rilmar/chimera-toolchanger/3MF/README.md

To print use the standard voron settings. Not all parts are oriented correctly. All part should print without supports.
