rilmar/chimera-toolchanger/3MF/Chimera SB Mounting.3mf

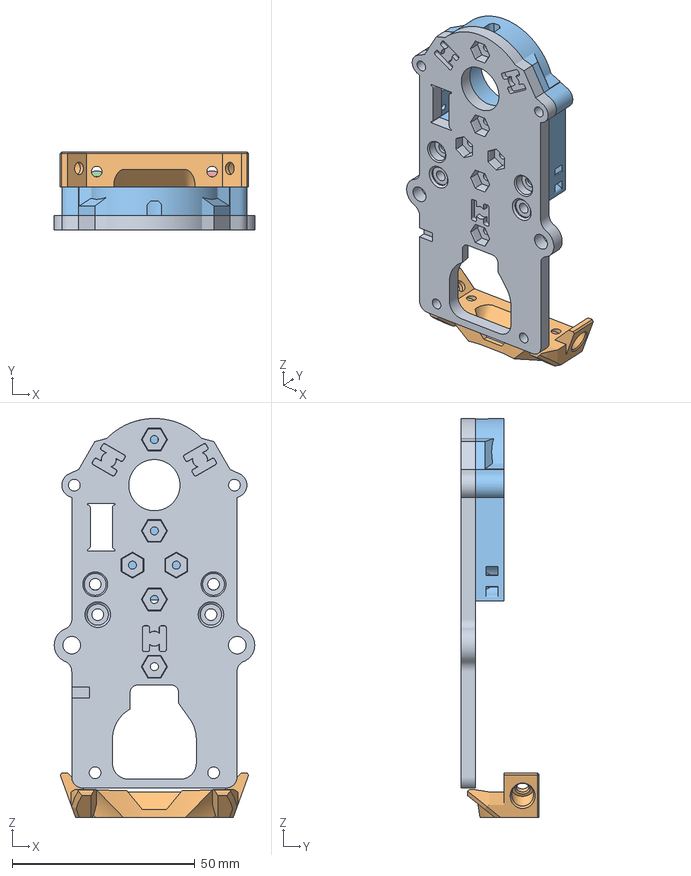
[picture p12: CAD file, 2026-11-12]
3MF/Chimera SB Mounting.3mf
54.9 x 21.4 x 109.3 mm
Toolhead_Plate_SB_mount
Chariot_Eddy_Probe_Mount
Motor_Spacer_SB
Lightweight_Carriage_Eddy_Probe_Spacer
Lightweight_Carriage_Eddy_Probe_Spacer_(2)
