rilmar/chimera-toolchanger/3MF/Chimera Tool.3mf

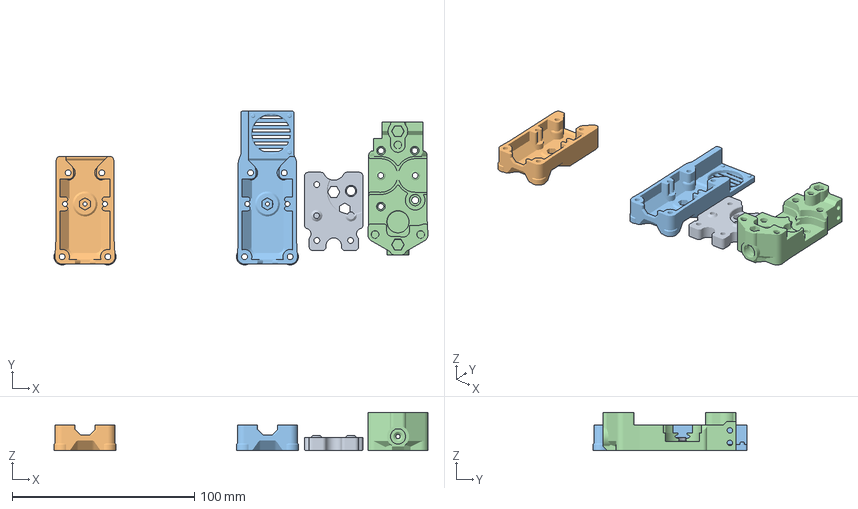
[picture p13: CAD file, 2026-11-11]
3MF/Chimera Tool.3mf
205.1 x 84.4 x 21.0 mm
Tool_Rear_(1)
Minimal_Cover
Full_Cover
Tool_Mid_(1)
