rilmar/chimera-toolchanger/3MF/Minimized Y Endstop Bumper.stl

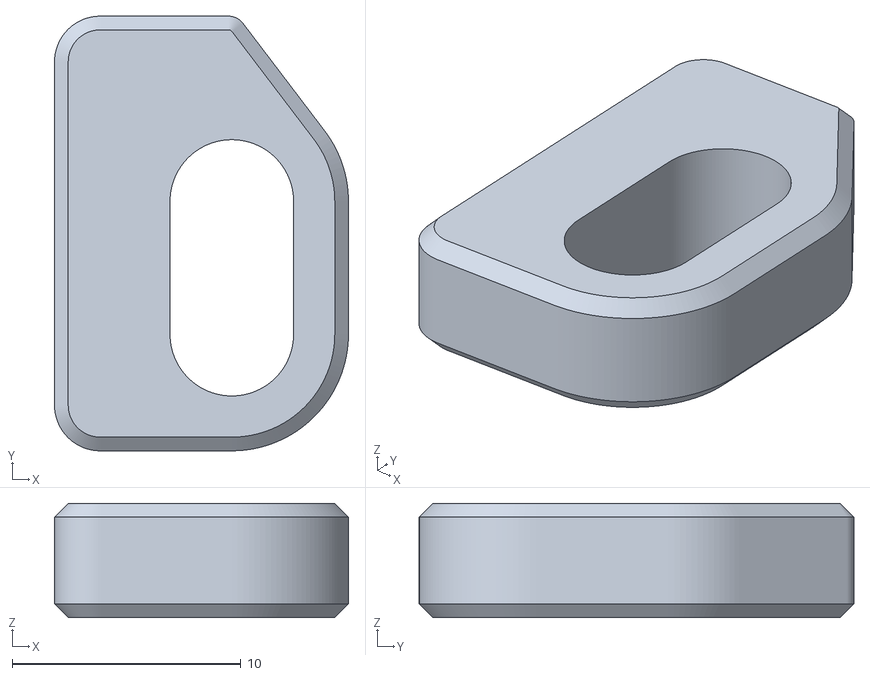
[picture p14: CAD file, 2026-11-02]
3MF/Minimized Y Endstop Bumper.stl
12.8 x 19.0 x 5.00
