rilmar/chimera-toolchanger/3MF/Chimera Dock 1515.3mf

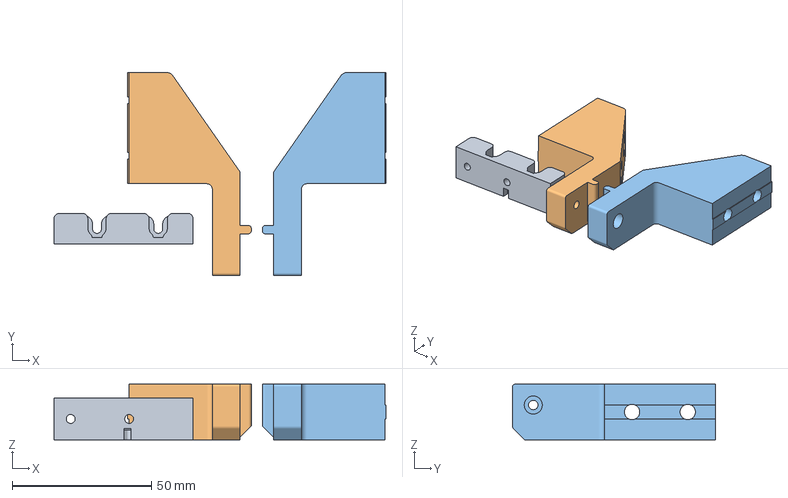
[picture p15: CAD file, 2026-11-02]
3MF/Chimera Dock 1515.3mf
119.3 x 73.0 x 20.0 mm
Mirror3_(2)
Mirror3_(3)
