rilmar/chimera-toolchanger/3MF/Chimera Toolhead.3mf

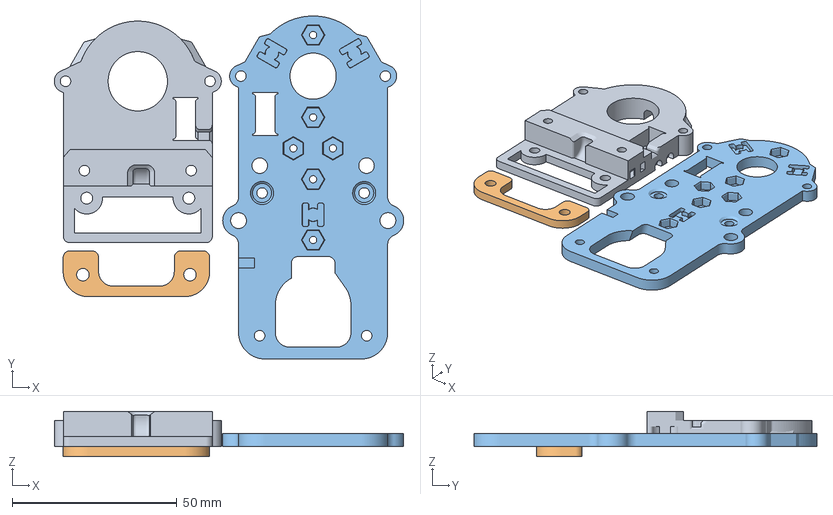
[picture p16: CAD file, 2026-11-02]
3MF/Chimera Toolhead.3mf
106.0 x 104.1 x 13.7 mm
Motor_Spacer_(1)
Carriage_Spacer_(1)
Coupling_plate_(1)
