rilmar/chimera-toolchanger/3MF/Chimera 3010 Fan Ducts.3mf

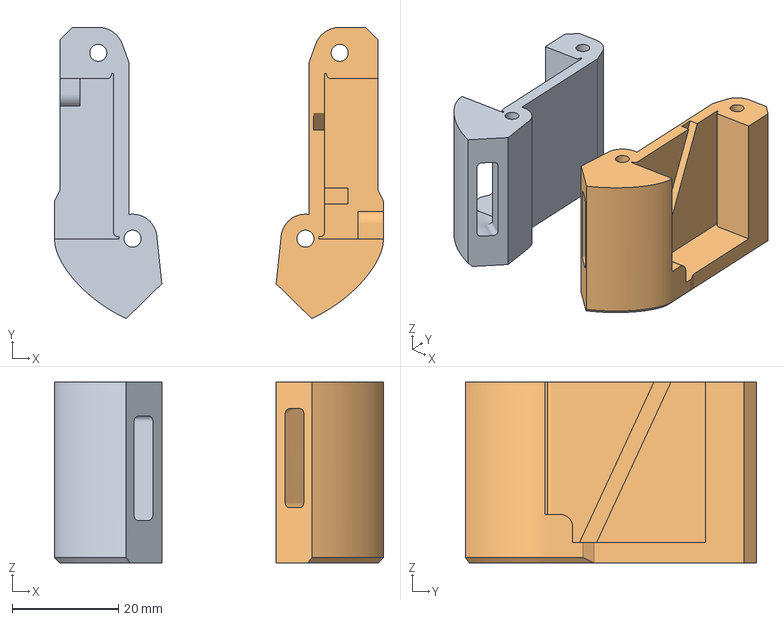
[picture p17: CAD file, 2026-11-02]
3MF/Chimera 3010 Fan Ducts.3mf
61.9 x 54.8 x 34.0 mm
Fan_Right_(1)
Fan_Left_(1)
