rilmar/chimera-toolchanger/3MF/Chimera Toolboards.3mf

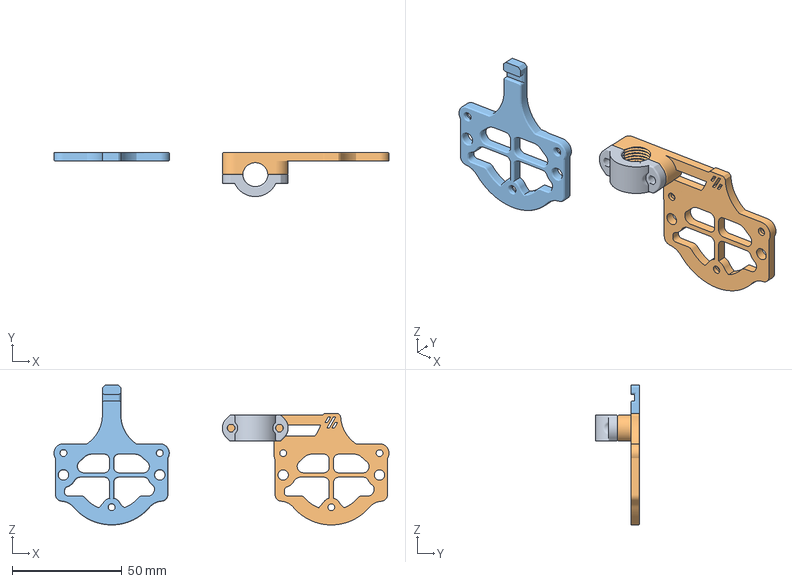
[picture p18: CAD file, 2026-11-02]
3MF/Chimera Toolboards.3mf
152.5 x 20.1 x 63.7 mm
PG7_Mount
Toolbaord_PG7
Toolboard_Mount_(1)
