rilmar/chimera-toolchanger/Changelog.md

# Changelog
* V0.3.1
  * Added a toolhead plate and spacer option for the standard lightweight carriage and the voron chariot
* V0.3.0
  * tighter tolerances on the extruder to facilitate better flexible printing.
  * Split CAD for toolhead and docks for easier management.
* V0.2.0
  * Added some room in the tool for wiring. Now allows 6 pin jst xh connector for connecting all wires at once.
* V0.1.0
    * Initial CAD upload
    * Initial write-up
    * Some media
