rilmar/chimera-toolchanger/(commit log)

2026-10-30 Revise README with detailed project overview and sections
    Updated the introduction to clarify project goals and mechanisms. Added sections on toolhead, tools, docks, BOM, and assembly instructions.
2026-10-31 Update README with current state of tool changing
    Added a section on the current state of tool changes and calibration, highlighting the need for supporting infrastructure like nozzle guards and tool sensing.
2026-11-02 Adding geometry
    [Chimera 3010 Fan Ducts.3mf, Chimera Dock 1515.3mf, Chimera Tool Standard.3mf, Chimera Toolboards.3mf, Chimera Toolhead.3mf]
2026-11-02 proofread and adding endstop bumper.
    [Minimized Y Endstop Bumper.stl]
2026-11-09 V0.2.0 - updated cad, 3mf, more images after testing
    [Chimera Tool Standard.3mf]
2026-11-11 Tightening Extruder tolerances, Separating toolhead and Dock cad files
    [Chimera Tool Standard.3mf, Chimera Tool.3mf]
2026-11-12 V0.3.1 Adding experimental support for stealburner style mounts, formalizing changelog.
    [Chimera SB Mounting.3mf]
